mrthomaschin/Tboard/Images/README.md

# Design


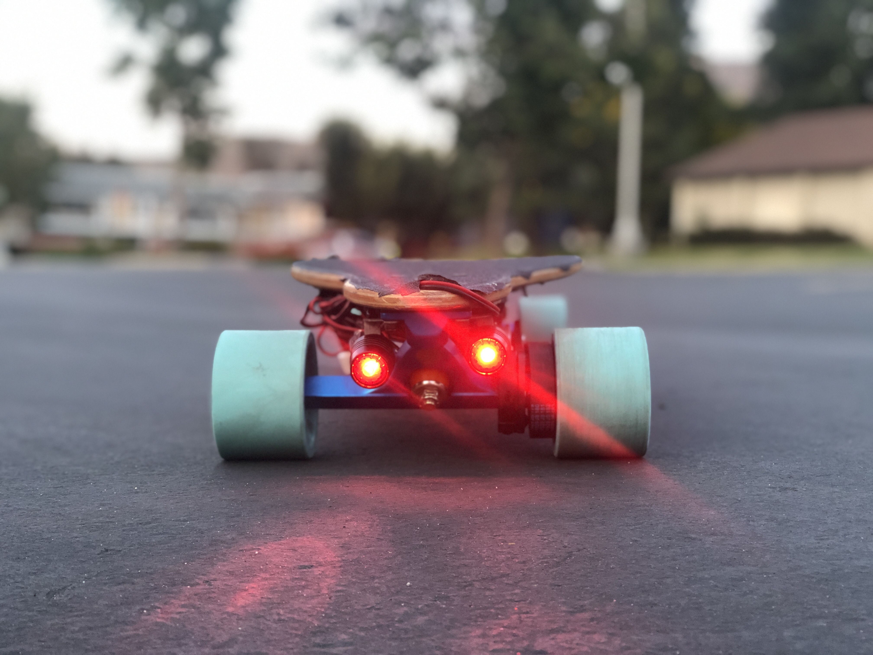
[picture p4: Images/IMG_0753.JPG]


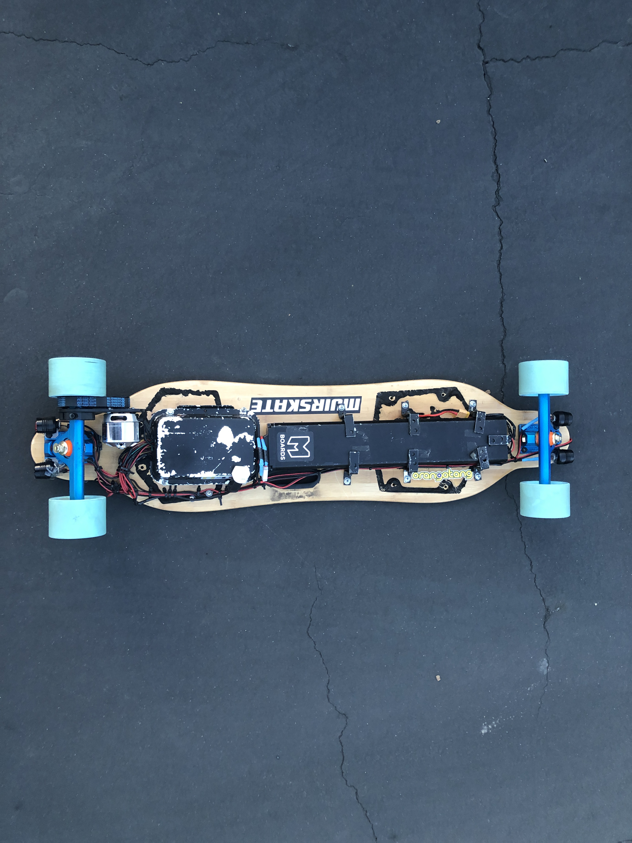
[picture p5: Images/IMG_0745.JPG]


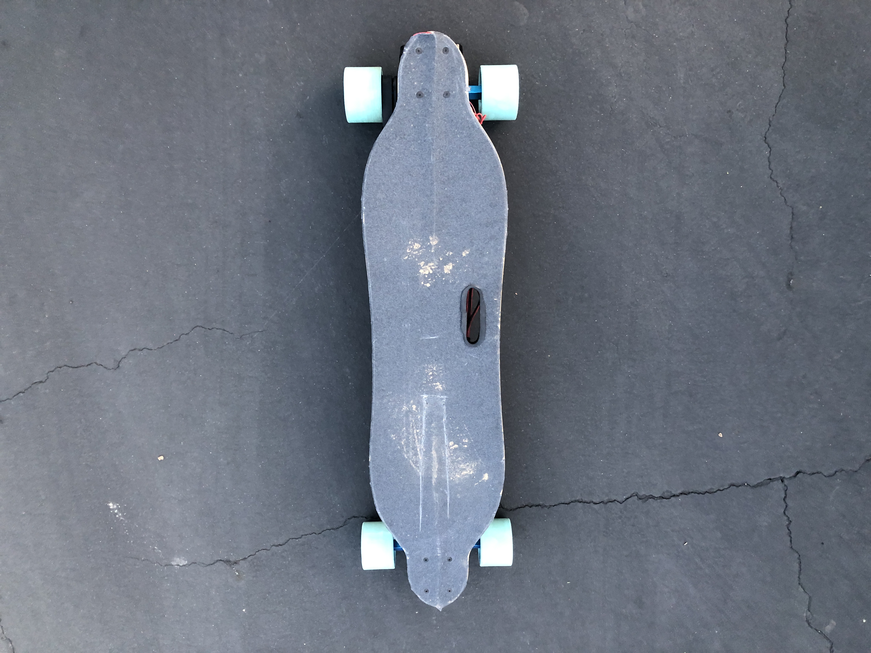
[picture p6: Images/IMG_0746.JPG]


# Wiring Diagram





# State Machines

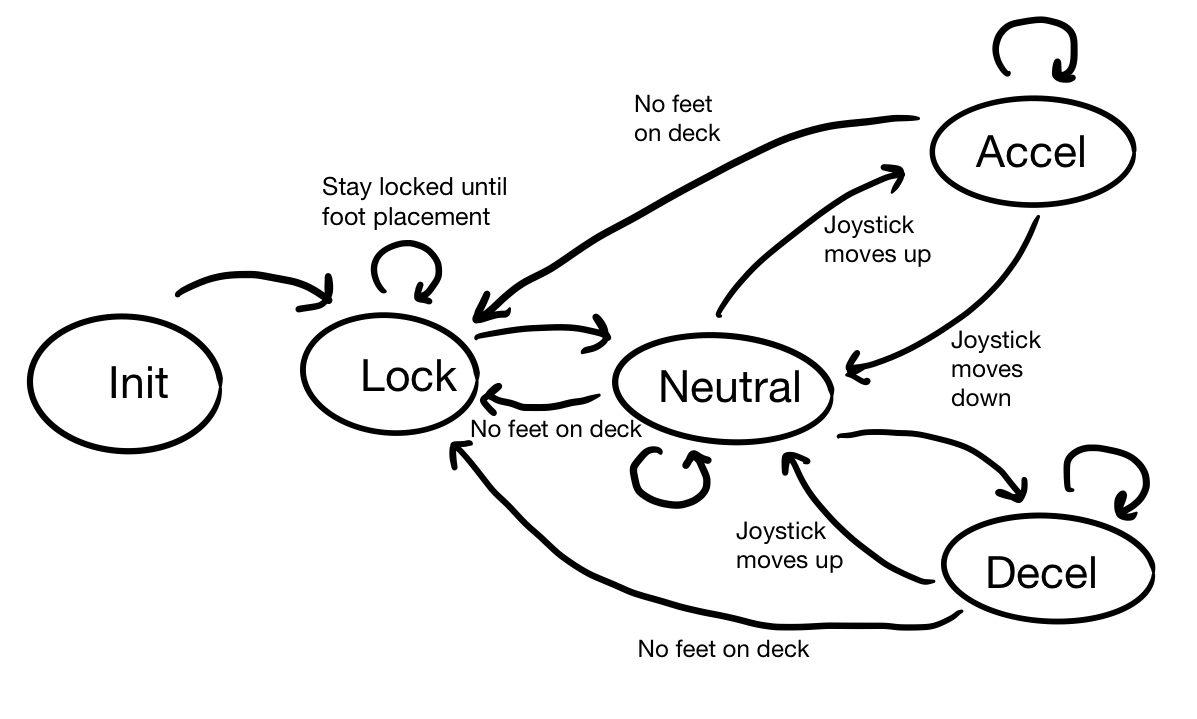
[picture p7: Images/IMG_0227.jpg]


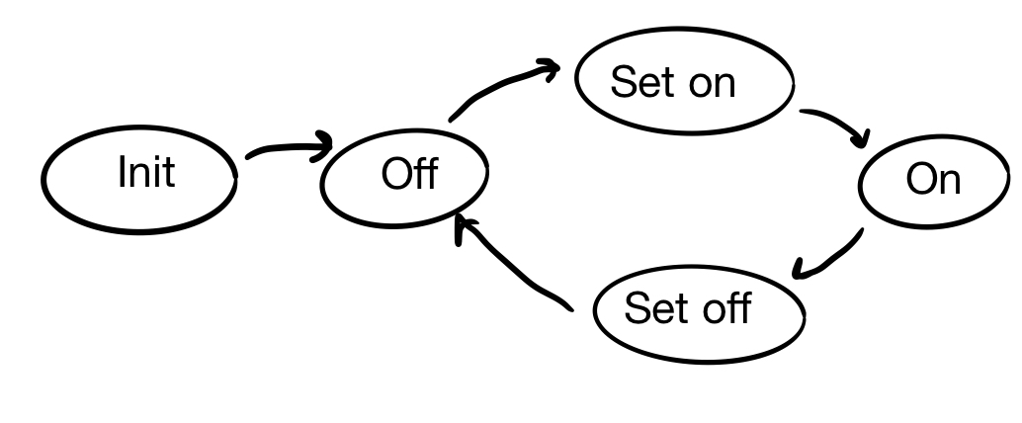
[picture p8: Images/IMG_0228.jpg]


# Flow Chart

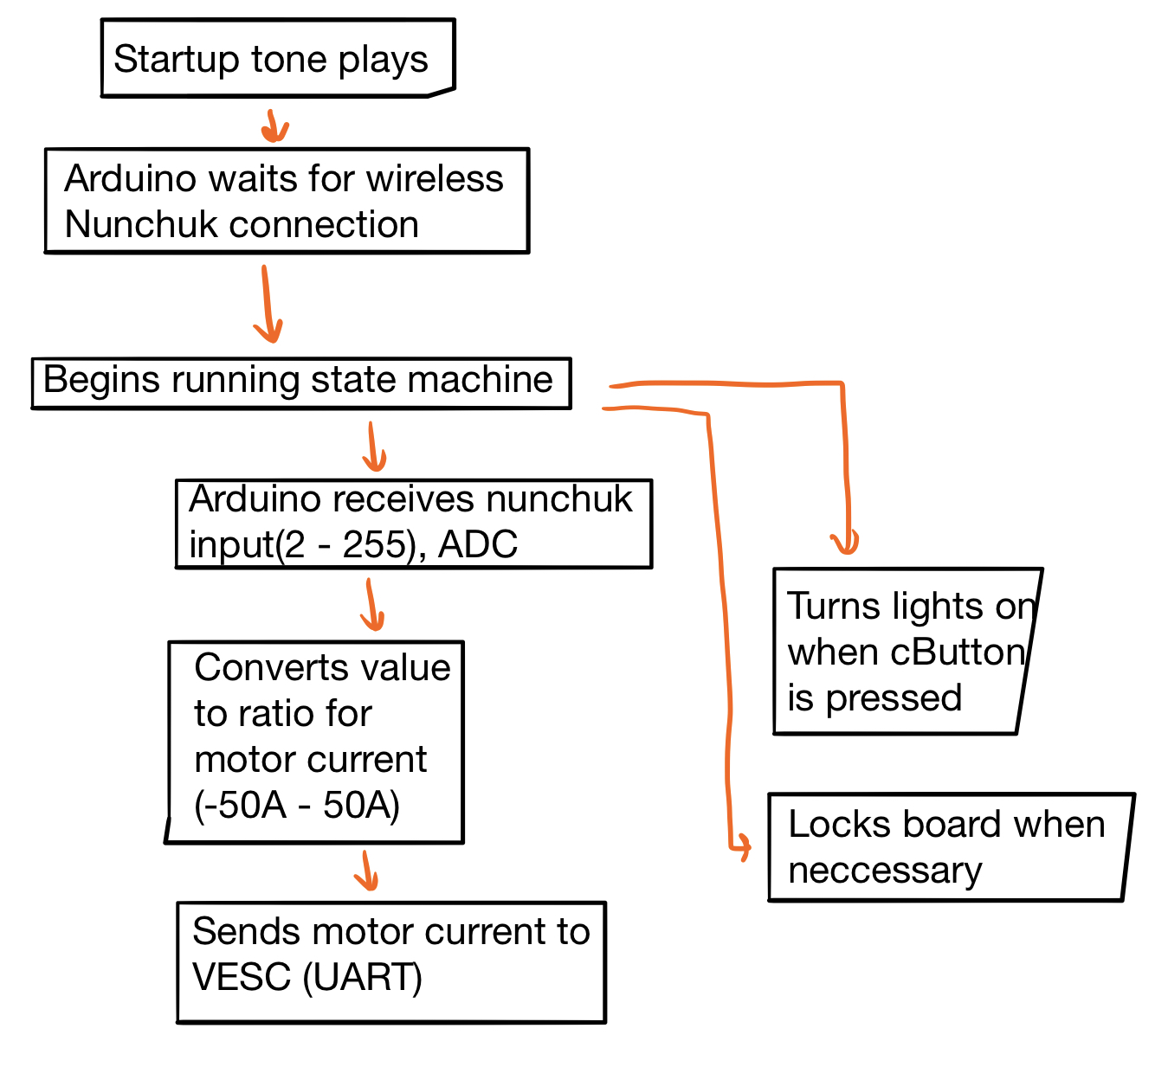
[picture p9: Images/IMG_0229.jpg]
