mrthomaschin/Tboard/Images/IMG_0645.jpg

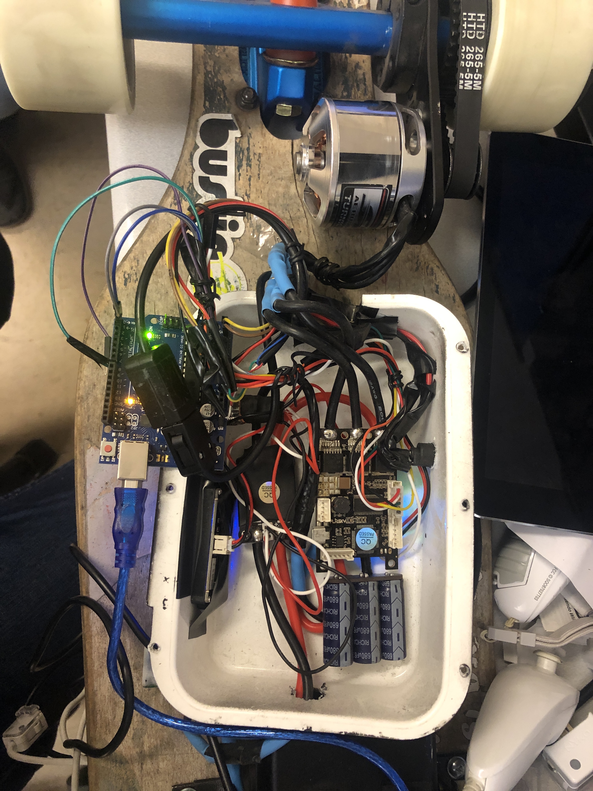
Images/IMG_0645.jpg
