mrthomaschin/Tboard/Images/IMG_0647.jpg

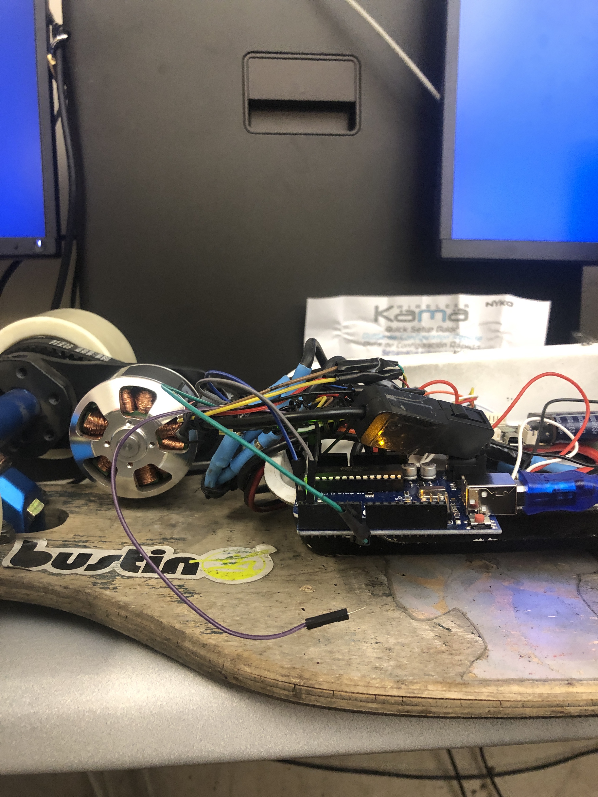
Images/IMG_0647.jpg
