mrthomaschin/Tboard/Images/IMG_0748.JPG

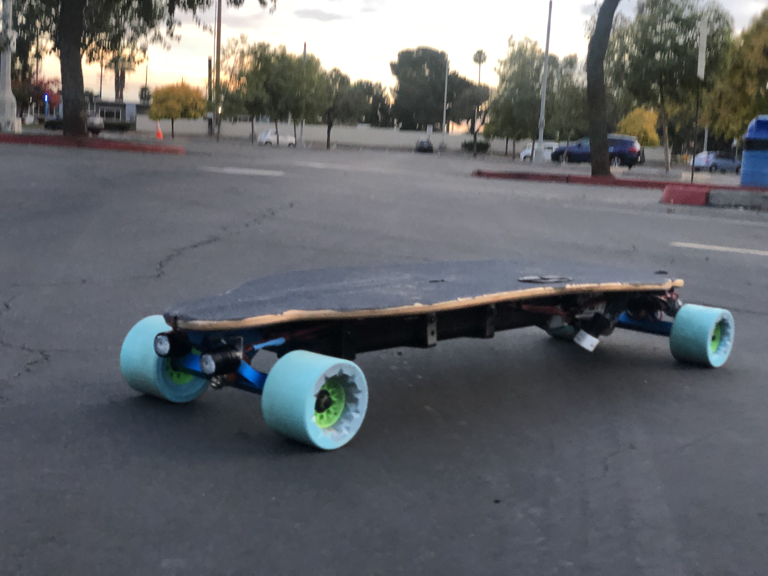
Images/IMG_0748.JPG
