mrthomaschin/Tboard/(commit log)

2019-11-20 Adding inital code. Motor spins in both directions
2019-12-11 Changed sensor logic
